AdityaHPatwardhan/Water_Surface-Cleaner/Servo_2.txt

#include <avr/io.h>           //Required to use assembler commands
#define F_CPU 16000000UL  // set the internal clock speed of 1 MHz
#include <util/delay.h>

int main(void)
{
	DDRD = (1 << PD7);
	DDRB = (1 << PB0);

	//for base of the arm
	while(1)
	{
		PORTB = (1 << PB0);
		_delay_ms(0.85);
		PORTB = (0 << PB0);
		_delay_ms(25);

		//for servo motor right above base
		PORTD = (1 << PD7);
		_delay_ms(1.5);
		PORTD = (0 << PD7);
		_delay_ms(20);

	}

}
