AdityaHPatwardhan/Water_Surface-Cleaner/atmega8.brd

## EAGLE design atmega8.brd (2018-12-15)

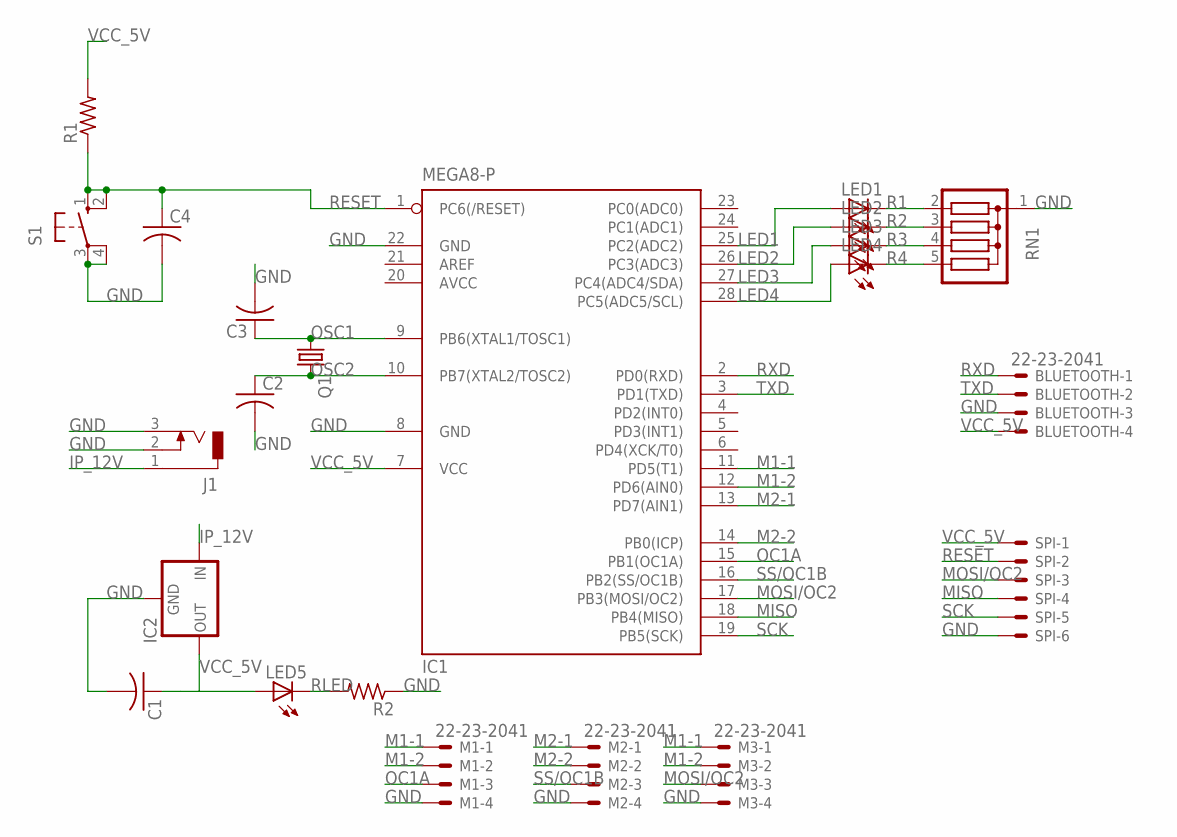
[picture p12: schematic atmega8.sch]

Parts:
BLUETOOTH: 22-23-2041
C1, C2, C3, C4: C-US050-025X075; C050-025X075
IC1: MEGA8-P; DIL28-3
IC2: 78XXL
J1: DCJ0303
LED1, LED2, LED3, LED4, LED5: LED3MM
M1, M2, M3: 22-23-2041
Q1: CRYSTALHC18U-V; HC18U-V
R1, R2: R-US_0204/7; 0204/7
RN1: G04R; SIL5
S1: 10-XX; B3F-10XX
SPI: 22-23-2061

Connections:
AVCC: IC1.20 (AVCC)
GND: BLUETOOTH.3, C1.2, C2.2, C3.2, C4.2, IC1.8 (GND), IC1.22 (GND), IC2.GND, J1.2, J1.3, M1.4, M2.4, M3.4, R2.1, RN1.1, S1.3, S1.4 (P1), SPI.6
IP_12V: IC2.IN, J1.1
LED1: IC1.25 (PC2(ADC2)), LED1.A
LED2: IC1.26 (PC3(ADC3)), LED2.A
LED3: IC1.27 (PC4(ADC4/SDA)), LED3.A
LED4: IC1.28 (PC5(ADC5/SCL)), LED4.A
M1-1: IC1.11 (PD5(T1)), M1.1, M3.1
M1-2: IC1.12 (PD6(AIN0)), M1.2, M3.2
M2-1: IC1.13 (PD7(AIN1)), M2.1
M2-2: IC1.14 (PB0(ICP)), M2.2
MISO: IC1.18 (PB4(MISO)), SPI.4
MOSI/OC2: IC1.17 (PB3(MOSI/OC2)), M3.3, SPI.3
OC1A: IC1.15 (PB1(OC1A)), M1.3
OSC1: C3.1, IC1.9 (PB6(XTAL1/TOSC1)), Q1.1
OSC2: C2.1, IC1.10 (PB7(XTAL2/TOSC2)), Q1.2
R1: LED1.K (C), RN1.2
R2: LED2.K (C), RN1.3
R3: LED3.K (C), RN1.4
R4: LED4.K (C), RN1.5
RESET: C4.1, IC1.1 (PC6(/RESET)), R1.1, S1.1 (S), S1.2 (S1), SPI.2
RLED: LED5.K (C), R2.2
RXD: BLUETOOTH.1, IC1.2 (PD0(RXD))
SCK: IC1.19 (PB5(SCK)), SPI.5
SS/OC1B: IC1.16 (PB2(SS/OC1B)), M2.3
TXD: BLUETOOTH.2, IC1.3 (PD1(TXD))
VCC_5V: BLUETOOTH.4, C1.1, IC1.7 (VCC), IC2.OUT, LED5.A, R1.2, SPI.1

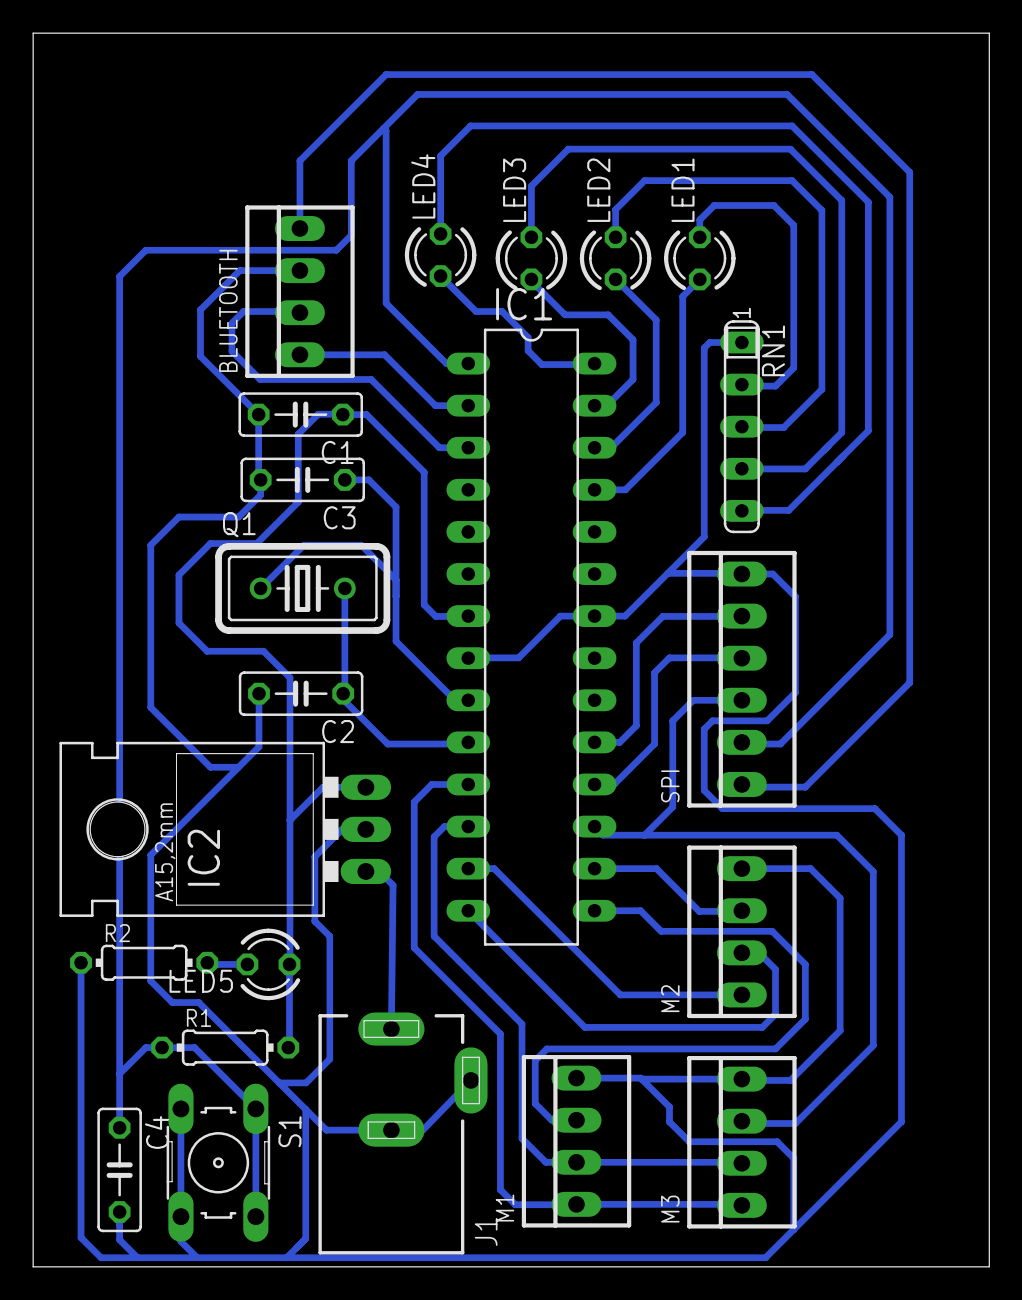
[picture p13: board atmega8.brd from above]

Board: 2 copper layers, 57.7 x 74.5 mm, 22 parts (0 on the bottom side), 26 nets.
